martinhaugen99/project_in5590/docs/261022_deliverable-1_draft-v4.md

# M.A.T.S: An Animatronic Desk Cleaner on Tracks

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

*Mechanized Assistant for Tabletop Sanitation. Revised draft, 22 October 2026. This version replaces the desk-companion proposal after the feedback on the first draft.*

---

## 1. Topic and motivation

Desks collect crumbs, eraser dust and dust. Wiping them away by hand pushes the debris onto the floor or into the user's lap, and a hand vacuum is loud and must be fetched first. We will build **M.A.T.S** (Mechanized Assistant for Tabletop Sanitation), a small robot that cleans a desk on its own. It drives on tracks and pushes the debris ahead of a brush to the table edge. There it lowers a bucket on two arms over the edge, and the brush pushes the debris into the bucket. When the bucket is full, a person lifts it off, empties it and puts it back.

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

## 2. Goals

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

1. **Physical design (main focus, Must).** Design the body, the track drive, the brush arm and the bucket arms in parametric CAD, then print and assemble them. The design succeeds when all of these tests pass:
   - **Reach:** the bucket arms move the bucket from its stowed position above the head to a position past the table edge, with the bucket rim below the table top, without touching the edge. Pass: 10 of 10 tries.
   - **Upright bucket:** the bucket carries a full load of test debris from the dump position to the stowed position and back without spilling. Pass: no debris lost in 10 tries.
   - **No tipping:** in the worst pose (bucket lowered past the edge and full, brush pushed forward), both tracks stay flat on the table. Pass: checked in CAD with measured masses, then 10 of 10 tries on the table.
   - **Detachable bucket:** a person removes and reattaches the bucket with one hand and no tools.
   - **Brush contact:** when lowered, the brush touches the table along its full width. When raised, it clears the table.
2. **Safety (Must).**
   - When driving forward, the robot stops before any part of a track leaves the surface, at every speed. Pass: 10 of 10 approaches per speed, both head-on and at 45° to the edge, on three different tables, with no code changes between the tables.
   - The robot reverses only along the path it has just driven, and it turns in place only where its corners stay on the table. Pass: no track leaves the surface during the 10 dump cycles in goal 4.
   - The tracks cannot move while the bucket is lowered or the brush is pushed forward. Pass: drive commands sent in these states are ignored in 10 of 10 tries.
   - If the laptop cable comes loose, all motors stop. Pass: 10 of 10 tries, with the tracks off the ground.
   - A physical switch on the robot cuts the external power to all motors, servos and the linear actuator.
3. **Mobility (Must).** Drive 1 m forward and 1 m back along a taped line, and turn 360° in place, first with the brush raised and then with it lowered. Pass: 5 of 5 runs of each test without stalling and without a track slipping or coming off, ending within 5 cm of the start.
4. **Dump cycle (Must).** At the press of a button, the robot runs one full cycle on its own: lower the brush, drive to the edge, square up to it, stop, lower the bucket, push, stow and back away (Section 3). Pass: 10 cycles in a row on one table, with no fall and no step that gets stuck.
5. **Expression (Must).** Show seven states as animations, not still images (Table 1). Pass: in a test with at least 10 people outside the group, a majority recognize each state.
6. **Collection rate, the optimization task (Should).** Increase the share of debris that ends up in the bucket (Section 3). Pass: we report the rate before and after tuning, and the tuned rate is at least 80 % by mass.
7. **Autonomous cleaning (Should).** The robot cleans a table on its own: it repeats the dump cycle along different edges until it is stopped. Pass: 5 minutes of cleaning on each of three tables, with no fall.
8. **Reactions (Should).** The face changes with the events in Table 1. Pass: each event, triggered by hand, shows the right face within 1 s.
9. **Could.** A camera that finds dirty spots, and sounds.

### Inspiration

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

## 3. Sketch and scope

Side views of the cleaning cycle

*Figure 1: Side views of the cleaning cycle, steps 1–5.*

Top and side views with dimensions and internal layout

*Figure 2: Top and side views with the main dimensions and the placement of the internal parts.*

**How M.A.T.S cleans** (Figure 1):

1. **Sweep.** The brush arm lowers the brush onto the table, and the robot drives forward. The debris collects in a pile ahead of the brush.
2. **Approach the edge.** The two edge sensors on the brush bracket see the edge. If only one of them sees it, the robot turns until both do, so that it stands square to the edge. The tracks stop while the pile is still on the table.
3. **Lower the bucket.** The bucket arms swing from above the head, over the brush and down, until the bucket hangs past the edge with its rim below the table top.
4. **Push.** The linear actuator pushes the brush forward along its rail, and the pile drops over the edge into the bucket.
5. **Stow and move on.** The actuator pulls the brush back, and the bucket rises to its place above the head. The robot then backs away along the path it came and turns toward a new strip of the table.

The tracks are locked during steps 3 to 5.

**Main parts** (labeled in Figures 1 and 2):

- **Body and head.** A 3D-printed PLA body. The display, a 2.8-inch color screen, sits in a fixed head on top of the body.
- **Tracks.** Two tracks printed in TPU as closed bands with teeth on the inside. They run on printed PLA sprockets with guide ridges. On each side, a DC gearmotor drives the rear sprocket, and the front sprocket runs free in a slotted mount, so that we can adjust the track tension after printing.
- **Encoders.** Each motor has a second output shaft, which turns an encoder through a printed TPU coupling. Each encoder has its own bracket, because its shaft takes at most 10 N of side load[^e6a2] and must not carry the track tension.
- **Brush arm.** One central arm at the front of the body, raised and lowered by a micro servo. The brush is fixed to the arm at an angle that makes it flat on the table when lowered. The arm lifts the brush only slightly, so the brush tilts only a little when raised. The brush slides on a guide rail at the tip of the arm. A linear actuator with a 20 mm stroke and position feedback pushes it forward and pulls it back[^pq12]. The rail takes the side loads, so the actuator only pushes along its own axis.
- **Bucket arms.** Two arms, one on each side of the body, fixed to a shaft through the middle of the body and driven by one micro servo. The arm hubs and the body leave room for a larger servo, in case the micro servo is too weak. The bucket hangs between the arm tips on two ball bearings, and ballast in its bottom keeps it upright in every arm position. The bucket rests on its pivots in open hooks, so a person can lift it off to empty it.
- **Edge sensors.** Two downward time-of-flight sensors sit at the left and right ends of the brush bracket, one ahead of each track, and ahead of the bristles. They run the safety reflex and guide the approach to the edge. With one sensor ahead of each track, the robot also sees an edge that it meets at an angle. The brush lifts only a few millimeters, while the drop at an edge is the full height of the table, so one threshold works with the brush up or down. If the arm fails and the sensors tilt up, they read a long distance, and the reflex stops the robot.
- **No rear sensors.** The robot reverses only along the path it has just driven, and never farther than the encoders measured on the way forward. Before it turns in place near an edge, it backs away until its corners stay on the table during the turn.
- **Inside the body.** One soldered board holds the microcontroller, the two motor driver chips and the pull-up and pull-down resistors. The body also holds the two step-down converters and the IMU. The motors and encoders sit low at the rear, as a counterweight to the bucket. The power cables and the cut-off switch are at the rear.

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

One 12 V bench supply powers all actuators through one cable:
- The linear actuator runs directly on 12 V.
- One adjustable step-down converter feeds the track motors. The motor driver chips drop part of the voltage[^l293d], so we set the converter so that the motors get about their suggested 4.5 V at full speed[^dg01d].
- A second converter feeds the servos at 5 V.
- The encoders run on 12 V, connected before the cut-off switch, so they keep counting when the motors are cut. Their outputs are open collector, so pull-up resistors to 3.3 V keep the signals at the microcontroller's logic level[^e6a2].

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

*Table 1: The seven states and their triggers.*

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

```
edge sensors (2), encoders, ──► LOW LEVEL ───────────────────► driver chip 1 ──► track motors (rear sprockets)
actuator position, IMU          edge reflex, dump interlock, ──► servo signals ──► brush-arm and bucket-arm servos
                                motor, servo and actuator    ──► driver chip 2 ──► linear actuator (brush push)
                                control, watchdog
                                   ▲ commands     │ state / events
buttons ──────────────────► HIGH LEVEL: cleaning behavior, emotion state ──► display renderer
```

The low level checks the edge sensors in every loop iteration before it applies any motor command, and it uses the encoders to keep the robot on its own path when it reverses. It lowers the bucket only when the tracks are stopped and both edge sensors see the edge ahead, and it keeps the tracks locked until the bucket is up and the brush is back. The high level can only send commands to the low level, so the cleaning behavior can never override the edge stop or the interlock. If the USB cable comes loose, the microcontroller loses power, and pull-down resistors on the driver inputs stop the motors.

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

## 4. Bill of materials (BOM)

We use the lab's equipment wherever we can. Only three items must be bought, all from RS, as the assignment asks. The last two rows are an optional part and a fallback, which we buy only if needed.

| # | Component | Part | Function | Qty | Source |
|---|---|---|---|---|---|
| 1 | Microcontroller | [Arduino Nano ESP32](https://store.arduino.cc/products/nano-esp32) (ESP32-S3, 3.3 V logic) | Low-level control, behavior and display | 1 | Lab |
| 2 | Track motors | [DAGU DG01D 48:1 hobby gearmotor](https://www.sparkfun.com/hobby-gearmotor-140-rpm-pair.html), output shaft on both sides | Drive the rear sprockets | 2 | Lab |
| 3 | Encoders | Yumo E6A2-CW3C, 200 pulses per turn, open-collector outputs (same as the [Omron E6A2-CW3C](https://www.fa.omron.co.jp/data_pdf/cat/e6a2-c_ds_e_8_2_csm490.pdf)) | Measure the motion of each track | 2 | Lab |
| 4 | Motor drivers | [TI L293DNE](https://www.ti.com/product/L293D), two motor channels per chip | One chip for the track motors, one for the linear actuator | 2 | Lab |
| 5 | Arm servos | [DFRobot SER0006 micro servo](https://www.digikey.com/en/products/detail/dfrobot/SER0006/7597224) | Raise and lower the brush arm and the bucket arms | 2 | Lab |
| 6 | Spare arm servo | Larger hobby servo | Replaces a micro servo that turns out to be too weak | 1 | Lab |
| 7 | Linear actuator | [Actuonix PQ12-100-12-P](https://www.robotshop.com/products/actuonix-pq12-p-linear-actuator-20mm-1001-12v-potentiometer) (20 mm stroke, 12 V, position feedback) | Push the brush forward and pull it back | 1 | Lab |
| 8 | Display | 2.8" SPI TFT module, ILI9341 controller, 240 × 320 pixels (board V1.2) | The face | 1 | Lab |
| 9 | IMU | [SparkFun OpenLog Artemis](https://www.sparkfun.com/sparkfun-openlog-artemis.html) (built-in ICM-20948 IMU), data over its serial TX pin | Detect tilt and pick-up (Should) | 1 | Lab |
| 10 | Buttons | Push buttons | Start and stop; "bucket emptied" | 2 | Lab |
| 11 | Power supply | Bench power supply set to 12 V, with cable | Power for all actuators | 1 | Lab |
| 12 | Step-down converters | Adjustable step-down (buck) converter, model to be confirmed | Motor rail and 5 V servo rail | 2 | Lab |
| 13 | Cut-off switch | Switch in the 12 V cable, mounted on the robot | Cut the power to all actuators | 1 | Lab |
| 14 | Edge sensors | [ST SATEL-VL53L4CD](https://no.rs-online.com/web/p/sensor-development-tools/2410906) (RS 241-0906), VL53L4CD time-of-flight sensor, two boards per kit | Safety reflex and edge approach, one sensor ahead of each track | 2 kits (2 sensors used, 2 spare) | Buy: RS |
| 15 | Brush | [RS PRO nylon brush strip](https://no.rs-online.com/web/p/door-seals/3269814) (RS 326-9814), cut to width | The brush | 1 | Buy: RS |
| 16 | Bearings | [RS PRO 623-2Z ball bearing](https://no.rs-online.com/web/p/ball-bearings/2612628), 3 × 10 × 4 mm (RS 261-2628) | Bucket pivots | 2 | Buy: RS |
| 17 | Ballast | Lead or steel weights | Keep the bucket upright | – | Lab |
| 18 | Filament | PLA and TPU | Printed parts; TPU for the tracks and the encoder couplings | – | Lab |
| 19 | Small parts | Solderable board, IC sockets, pull-up and pull-down resistors, wires, connectors, M2/M3 screws | Assembly | – | Lab |
| 20 | Camera (Could) | Raspberry Pi 5 and Raspberry Pi camera | Find dirty spots | 1 | Lab |
| 21 | Pin expander (optional) | [Microchip MCP23017-E/SP](https://www.digikey.com/en/products/detail/microchip-technology/MCP23017-E-SP/894272), 16 pins over I2C, through-hole | More pins, if the microcontroller runs short | 1 | Buy if needed: DigiKey or RS (RS 040-3806) |
| 22 | Tracks (fallback) | [Pololu 30T track set](https://www.pololu.com/product/3033) (#3033) | Replace the printed tracks if they fail | 1 set | Buy if needed: [DigiKey](https://www.digikey.no/no/supplier-centers/pololu) |

When the model of the lab's step-down converters is known, we check it and the motor drivers against the stall currents of the motors and servos. The bearing size will be confirmed in CAD.

## 5. Plan

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

| Iteration | Week (dates) | Main tasks (responsible) | Milestone: done when |
|---|---|---|---|
| I0 | W41–W42 (5–18 Oct) | First proposal, Deliverable 4A (11 Oct) and the 4B project review (both) | **M0:** Done. The concept was changed after the feedback |
| I1 | W43 (19–25 Oct) | Revised concept, sketches and deliverable (both); collect the lab parts and send the order list for the edge sensors, brush and bearings to the faculty (Yuki); CAD v0: layout of the main parts and the arm geometry, using measured part sizes (Martin) | **M1:** The revised deliverable is handed in, the lab parts are in hand, and the order list is sent |
| I2 | W44 (26 Oct–1 Nov) | CAD v1 of the body, track drive, brush arm and bucket arms (Martin); test prints: a TPU track section with sprockets, the encoder couplings, the arm hubs on the servos, the brush rail with the linear actuator, and the bucket mount with bearings and ballast (Martin); bring up the motors with encoders and driver chips, the servos, the linear actuator, the display and the IMU data stream on the bench (Yuki); design the faces on the laptop (Martin) | **M2:** CAD v1 is done, and each test print and part works on the bench |
| I3 | W45 (2–8 Nov) | Print and assemble robot v1 (Martin); track control with the encoders, speed cap, watchdog, motor stop on a lost USB cable, edge reflex and the reversing rule (Yuki); Project part 1, due 8 Nov (both) | **M3:** The robot passes the mobility test and stops at the edge on a table, and Project part 1 is handed in |
| I4 | W46 (9–15 Nov) | Arm control, the linear actuator, squaring up to the edge, and the dump cycle with its interlock (Yuki); reach, tipping and servo-torque tests, and CAD v2 from the results (Martin); faces on the display (Martin); Project part 2, due 15 Nov (both) | **M4 (MVP):** On a real table, the robot runs a full dump cycle at the press of a button and never falls off, and Project part 2 is handed in |
| I5 | W47 (16–22 Nov) | Print and assemble v2 (Martin); autonomous cleaning (Yuki); collection-rate experiments and tuning (Yuki); animate the seven states and connect them to events (Martin) | **M5:** Feature freeze: the robot cleans a table on its own, and the experiment data is logged |
| I6 | W48 (23–29 Nov) | Emotion recognition test (Martin); tests on three tables (Yuki); fixes, demo rehearsal and spare parts (both) | **M6:** The robot is ready for the demo |
| Demo | Monday 30 Nov | Public demo, Project part 3 (both) | **M7:** Demo done |

**Main areas of responsibility**

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

**Risks and what we do about them**

| Risk | What we do |
|---|---|
| The bought edge sensors arrive late | Send the order in I1, and test the drive and the arms with lab parts until the sensors arrive. |
| The printed TPU tracks slip, stretch or come off | Print and test a track section in I2, adjust the tension with the slotted front mounts, and use guide ridges on the sprockets. The fallback is the Pololu track set. |
| The robot meets an edge at an angle | One edge sensor sits ahead of each track, and we test approaches at 45° in the safety tests. |
| The robot tips forward with the bucket out past the edge | Check the center of gravity in CAD with measured masses, and place the motors and encoders low at the rear. If the IMU is fitted, it also stops the robot when it tilts. |
| A micro servo is too weak for the bucket arms | Check the torque in CAD with measured masses, and swap in the larger lab servo, which the arm hubs and the body already fit. A counterweight behind the arm pivot also reduces the load. |
| A driver chip gets too hot when a track motor stalls | The firmware detects a stall from the encoders and cuts the motor. The fallback for the track motors is an L298N driver module that we already have. |
| The printed sprockets or encoder couplings slip on the plastic motor shafts | Measure the shafts, and print several bore sizes in one test print in I2. |
| The pile falls off the edge before the bucket is in place | The edge sensors sit on a bracket ahead of the bristles, and we tune the stop gap. |
| The 20 mm stroke is too short to push the pile into the bucket | Place the edge sensors so that the stop gap fits within the stroke, and use the encoders to stop accurately. A lever on the rail can lengthen the push. |
| The bucket swings when the debris lands in it | Tune the ballast mass and the friction in the pivots, and add a soft end stop. |
| The microcontroller has too few pins | Use one shutdown pin for both edge sensors, tie the display's chip-select low, and read both buttons on one analog pin. The MCP23017 pin expander is the fallback. |
| We fall behind the schedule | Drop the Could goals first, then autonomous cleaning, and keep the dump cycle at the press of a button. The MVP (M4) has priority, and I6 has time for fixes. |

---

[^roomba]: "Roomba," *Wikipedia*. <https://en.wikipedia.org/wiki/Roomba> (accessed 21 October 2026).
[^cozmo-sdk]: Anki, *Cozmo Python SDK*, `robot.py`, methods `is_cliff_detected` and `enable_stop_on_cliff`. <https://github.com/anki/cozmo-python-sdk/blob/master/src/cozmo/robot.py>
[^cozmo]: "Cozmo," *Wikipedia*. <https://en.wikipedia.org/wiki/Cozmo> (accessed 21 October 2026).
[^walle]: "WALL-E (character)," *Wikipedia*. <https://en.wikipedia.org/wiki/WALL-E_(character)> (accessed 21 October 2026).
[^zumo]: Pololu, "Zumo 32U4 Robot," item #3125. <https://www.pololu.com/product/3125> (accessed 9 October 2026).
[^takayama]: L. Takayama, D. Dooley and W. Ju, "Expressing thought: improving robot readability with animation principles," in *Proc. 6th ACM/IEEE International Conference on Human-Robot Interaction (HRI)*, 2011, pp. 69–76. [doi:10.1145/1957656.1957674](https://doi.org/10.1145/1957656.1957674)
[^vanbreemen]: A. J. N. van Breemen, "Bringing robots to life: Applying principles of animation to robots," in *Proc. Shaping Human-Robot Interaction Workshop, CHI 2004*, Vienna, Austria, 2004.
[^e6a2]: OMRON, "Incremental 25-mm-dia. Rotary Encoder E6A2-C," datasheet CSM_E6A2-C_DS_E_8_2. <https://www.fa.omron.co.jp/data_pdf/cat/e6a2-c_ds_e_8_2_csm490.pdf>
[^pq12]: Actuonix, "PQ12 Micro Linear Actuators," datasheet. <https://cdn.robotshop.com/media/f/fir/rb-fir-42/pdf/actuonix-pq12-datasheet.pdf> (accessed 22 October 2026).
[^dg01d]: SparkFun, "Hobby Gearmotor - 140 RPM (Pair)," ROB-13302. <https://www.sparkfun.com/hobby-gearmotor-140-rpm-pair.html> (accessed 22 October 2026).
[^l293d]: Texas Instruments, "L293x Quadruple Half-H Drivers," datasheet SLRS008D. <https://www.ti.com/lit/gpn/l293d> (accessed 22 October 2026).
[^ekman]: P. Ekman, "An argument for basic emotions," *Cognition and Emotion*, vol. 6, no. 3–4, pp. 169–200, 1992. [doi:10.1080/02699939208411068](https://doi.org/10.1080/02699939208411068)
