martinhaugen99/project_in5590/docs/figures/1exploded.png

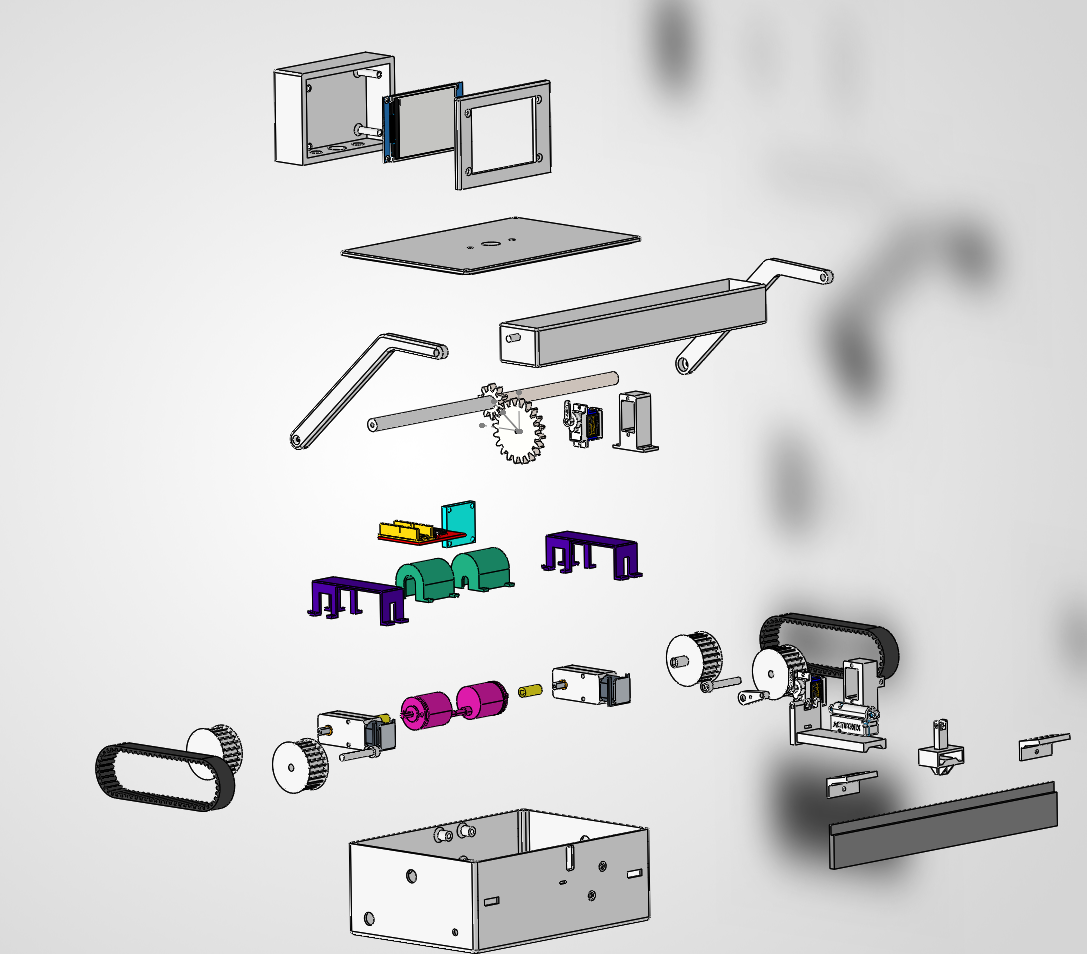
docs/figures/1exploded.png
