martinhaugen99/project_in5590/bom.csv

item | component | part | function | mpn | supplier | link | datasheet | qty | unit_price | currency | unit_price_nok | status | price_checked | notes
1 | microcontroller | Arduino Nano ESP32 | Low-level control, behavior and display |  | Lab | https://store.arduino.cc/products/nano-esp32 |  | 1 |  |  |  | lab |  | ESP32-S3, 3.3 V logic. D004
2 | drive_motor | DAGU DG01D 48:1 hobby gearmotor | Drive the rear sprockets | DG01D | Lab | https://www.sparkfun.com/hobby-gearmotor-140-rpm-pair.html |  | 2 |  |  |  | lab |  | Output shaft on both sides. About 140 RPM without load, suggested 4.5 V (SparkFun ROB-13302). D006
3 | encoder | Yumo E6A2-CW3C rotary encoder | Measure the motion of each track | E6A2-CW3C | Lab |  | https://www.fa.omron.co.jp/data_pdf/cat/e6a2-c_ds_e_8_2_csm490.pdf | 2 |  |  |  | lab |  | 200 pulses per turn, open-collector outputs. Same as the Omron E6A2-CW3C. Shaft side load at most 10 N, so each encoder has its own bracket. D006
4 | motor_driver | TI L293DNE | One chip for the track motors, one for the linear actuator | L293DNE | Lab | https://www.ti.com/product/L293D | https://www.ti.com/lit/gpn/l293d | 2 |  |  |  | lab |  | Two motor channels per chip. Fallback for the track motors: L298N driver module (lab). D006
5 | servo | DFRobot SER0006 micro servo | Raise and lower the brush arm and the bucket arms | SER0006 | Lab | https://www.digikey.com/en/products/detail/dfrobot/SER0006/7597224 | https://www.dfrobot.com/product-255.html | 2 |  |  |  | lab |  | Turns 180°. D008
6 | servo | Larger hobby servo | Replaces a micro servo that turns out to be too weak |  | Lab |  |  | 1 |  |  |  | lab |  | Spare. The arm hubs and the body leave room for it. D008
7 | linear_actuator | Actuonix PQ12-100-12-P | Push the brush forward and pull it back | PQ12-100-12-P | Lab | https://www.robotshop.com/products/actuonix-pq12-p-linear-actuator-20mm-1001-12v-potentiometer | https://cdn.robotshop.com/media/f/fir/rb-fir-42/pdf/actuonix-pq12-datasheet.pdf | 1 |  |  |  | lab |  | 20 mm stroke, 12 V, position feedback. D008
8 | display | 2.8 in SPI TFT module, ILI9341 controller, 240 x 320 pixels (board V1.2) | The face |  | Lab |  |  | 1 |  |  |  | lab |  | Datasheet of the module not yet linked. D009
9 | imu | SparkFun OpenLog Artemis | Detect tilt and pick-up (Should) |  | Lab | https://www.sparkfun.com/sparkfun-openlog-artemis.html |  | 1 |  |  |  | lab |  | Built-in ICM-20948 IMU, data over its serial TX pin. D010
10 | button | Push button | Start and stop; bucket emptied |  | Lab |  |  | 2 |  |  |  | lab
11 | power_supply | Bench power supply set to 12 V, with cable | Power for all actuators |  | Lab |  |  | 1 |  |  |  | lab |  | D005
12 | step_down_converter | Adjustable step-down (buck) converter | Motor rail and 5 V servo rail |  | Lab |  |  | 2 |  |  |  | lab |  | Model to be confirmed. Then check it and the motor drivers against the stall currents of the motors and servos. D005
13 | motor_cutoff_switch | Switch in the 12 V cable, mounted on the robot | Cut the power to all actuators |  | Lab |  |  | 1 |  |  |  | lab |  | D005
14 | edge_sensor | ST SATEL-VL53L4CD, VL53L4CD time-of-flight sensor, two boards per kit | Safety reflex and edge approach, one sensor ahead of each track | SATEL-VL53L4CD | RS | https://no.rs-online.com/web/p/sensor-development-tools/2410906 |  | 1 |  |  |  | to_order |  | One kit, two sensors. RS 241-0906. D007
15 | brush | RS PRO nylon brush strip, cut to width | The brush |  | RS | https://no.rs-online.com/web/p/door-seals/3269814 |  | 1 |  |  |  | to_order |  | RS 326-9814. D008
16 | bearing | Ball bearings | Bucket pivots |  | Lab |  |  | 2 |  |  |  | lab |  | Size to be measured. D008
17 | ballast | Lead or steel weights | Keep the bucket upright |  | Lab |  |  |  |  |  |  | lab |  | D008
18 | filament | PLA and TPU | Printed parts; TPU for the tracks and the encoder couplings |  | Lab |  |  |  |  |  |  | lab
19 | small_parts | Solderable board, IC sockets, pull-up and pull-down resistors, wires, connectors, M2/M3 screws | Assembly |  | Lab |  |  |  |  |  |  | lab
20 | camera | Raspberry Pi 5 and Raspberry Pi camera | Find dirty spots (Could) |  | Lab |  |  | 1 |  |  |  | optional |  | D004
