martinhaugen99/project_in5590/(list of files, cad)

Other CAD files:
cad/bucket_arms/bucket_arms.SLDASM
cad/mats.SLDASM
cad/track_drive/track_drive.SLDASM
cad/body/body.SLDASM
cad/head/head.SLDASM
cad/brush_arm/brush_arm.SLDASM
cad/body/body_chassis.SLDPRT
cad/brush_arm/guide_rail.SLDPRT
cad/head/head_box_back.SLDPRT
cad/brush_arm/coupling_brush_linear_actuator.SLDPRT
cad/bucket_arms/bucket_arms_gear_rod_reduced.SLDPRT
cad/track_drive/track.SLDPRT
cad/body/solderable_breadboard.SLDPRT
cad/bucket_arms/bucket_arms_gear_rod.SLDPRT
cad/head/head_lid_face.SLDPRT
cad/track_drive/track_sprocket_idler.SLDPRT
cad/body/imu.SLDPRT
cad/brush_arm/servo_mount_brush.SLDPRT
cad/bucket_arms/bucket_arm.SLDPRT
cad/track_drive/track_sprocket_drive.SLDPRT
cad/body/motor_mount.SLDPRT
cad/brush_arm/edge_sensor_mount.SLDPRT
cad/bucket_arms/Mirrorbucket_arm.SLDPRT
cad/track_drive/track_round.SLDPRT
cad/body/encoder_mount.SLDPRT
cad/brush_arm/coupling_servo_linear_actuator.SLDPRT
cad/bucket_arms/bucket_arms_servo_gear.SLDPRT
cad/body/body_lid.SLDPRT
cad/brush_arm/Mirroredge_sensor_mount.SLDPRT
cad/bucket_arms/servo_mount.SLDPRT
cad/body/coupling_drive_motor_encoder.SLDPRT
cad/brush_arm/brush.SLDPRT
cad/bucket_arms/rod.SLDPRT
cad/bucket_arms/bucket.SLDPRT
cad/purchased/display_2_8_in_spi.SLDPRT
cad/purchased/drive_motor_dg01d.SLDPRT
cad/purchased/edge_sensor_satel_vl53l4cd.SLDPRT
cad/purchased/encoder_e6a2_cw3c.SLDPRT
cad/purchased/imu_openlog_artemis.SLDPRT
cad/purchased/linear_actuator_pq12_100_12_p.SLDPRT
cad/purchased/microcontroller_nano_esp32.SLDPRT
cad/purchased/motor_driver_l293dne.SLDPRT
cad/purchased/servo_ser0006.SLDPRT
cad/track_drive/track_idler_screw.SLDPRT
