martinhaugen99/project_in5590/print_params.md

# Print parameters:

Layer height 0.2mm for all

**Make bigger holes**

## Body:

- body chassis: 40% infill
- body lid: 15% infill
- coupling drive motor encoder(x2): 100% infill - **redesign**
- encoder mount(x2): 60% infill
- motor mount(x2): 60% infill

## Head:

- head box back: 40% infill
- head lid face: 40% infill - fits

## Track Drive:

- track idler screw(x2): 100% infill
- track sprocket drive(x2): 60% infill
- track sprocket idler(x2): 60% infill
- track(x2, tpu):

## Bucket Arms:

- bucket: 40% infill
- bucket arm right: 40% infill
- bucket arm left(mirrored): 40% infill
- servo mount: 60% infill
- bucket arms servo gear: 100% infill
- rod: 100% infill
- bucket arms gear rod reduced: 100% infill

## Brush Arm:

- coupling brush linear actuator: 40% infill
- coupling servo linear actuator: 100% infill
- edge sensor mount: 40% infill
- guide rail slot: 40% infill
- mirrord edge sensor mount: 40% infill
- servo mount brush: 40% infill
