martinhaugen99/project_in5590/docs/figures/1assembled.png

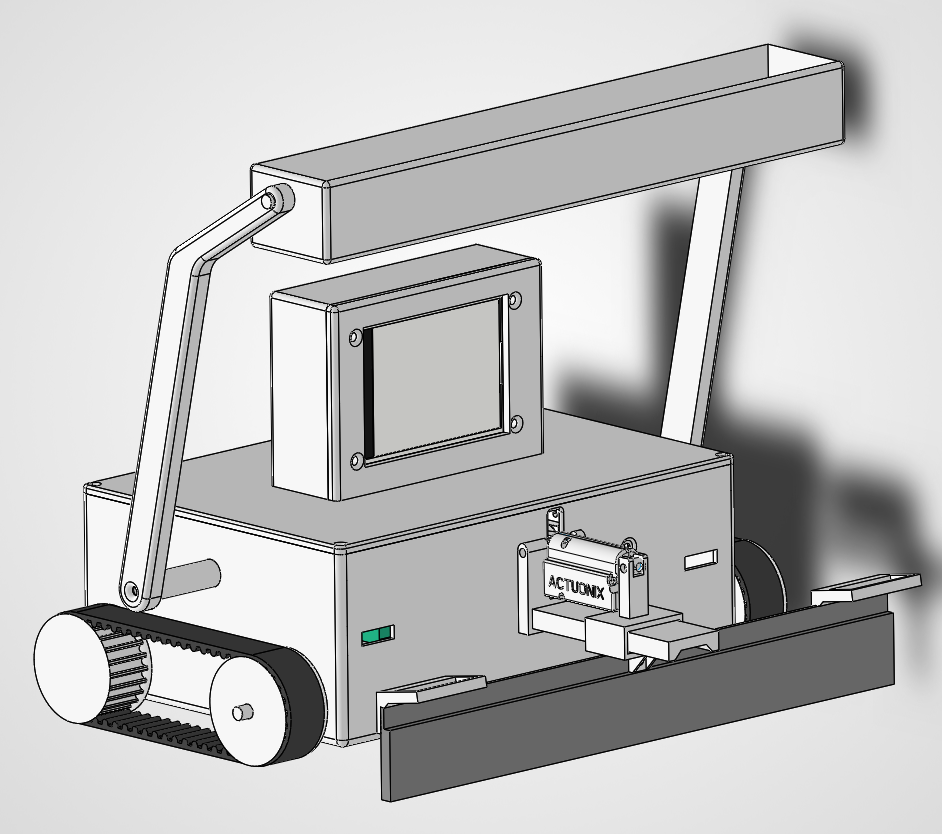
docs/figures/1assembled.png
