martinhaugen99/project_in5590/docs/how_to_uv_claude.png

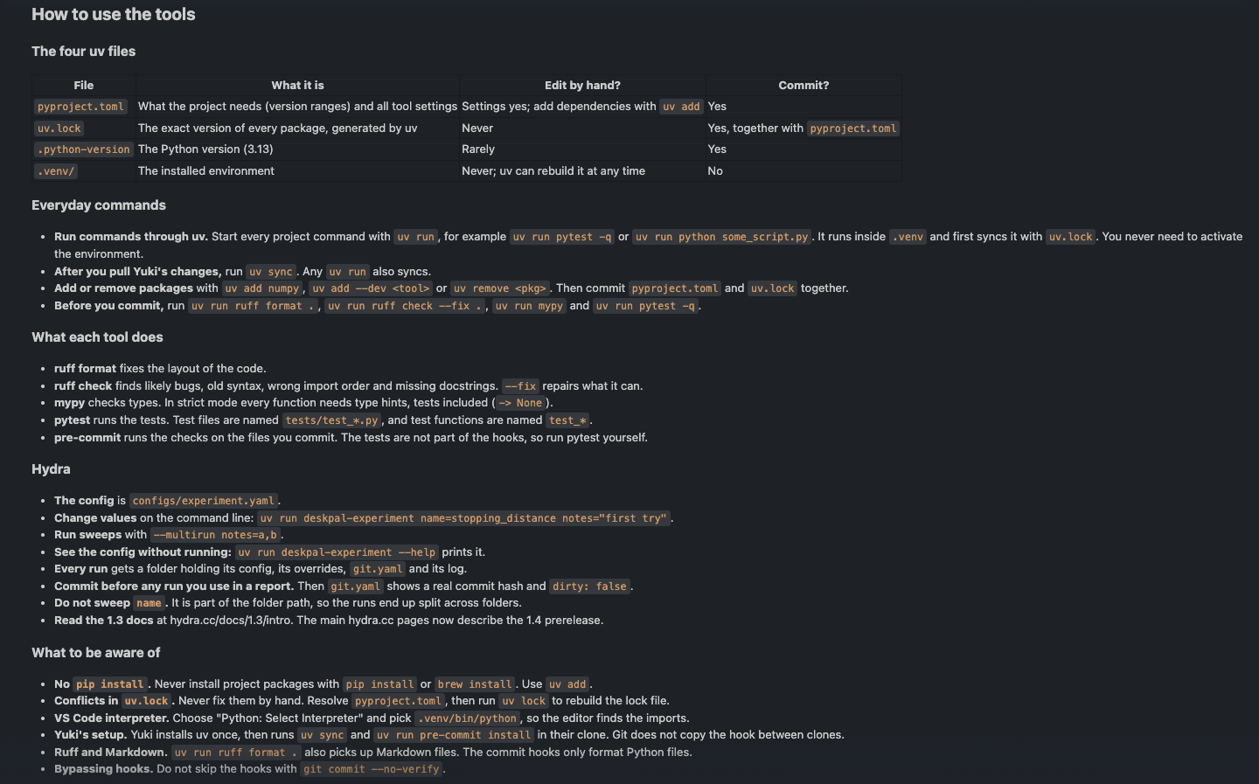
docs/how_to_uv_claude.png
