martinhaugen99/project_in5590/(commit log)

2026-10-10 add deliverable 1 draft, sketch and bom
    [bom.csv]
2026-10-24 rewrite bom for the M.A.T.S design
    [bom.csv]
2026-10-24 track solidworks files in git lfs with locks
2026-10-24 add cad structure and lock workflow
2026-10-24 add cad parameter table and module owners
2026-10-24 record decision D012 for shared cad dimensions
2026-11-03 add vendor models for motor, encoder, MCU
    [drive_motor_dg01d.SLDPRT, encoder_e6a2_cw3c.SLDPRT, microcontroller_nano_esp32.SLDPRT]
2026-11-06 add vendor models for sensors, servo, actuator
    [display_2_8_in_spi.SLDPRT, edge_sensor_satel_vl53l4cd.SLDPRT, imu_openlog_artemis.SLDPRT, linear_actuator_pq12_100_12_p.SLDPRT, motor_driver_l293dne.SLDPRT, servo_ser0006.SLDPRT]
2026-11-06 body_chassis: box with holes for screws; body: assembly with body chassis and drive motors
    [body.SLDASM, body_chassis.SLDPRT]
2026-11-07 fixed motor and encoder mount, updated body assembly
    [body.SLDASM, body_chassis.SLDPRT, drive_motor_dg01d.SLDPRT, encoder_mount.SLDPRT, motor_mount.SLDPRT]
2026-11-08 drive motor and encoder coupled, track drive, lid and full assembly created
    [body.SLDASM, body_chassis.SLDPRT, body_lid.SLDPRT, coupling_drive_motor_encoder.SLDPRT, mats.SLDASM, motor_mount.SLDPRT, solderable_breadboard.SLDPRT, track.SLDPRT]
2026-11-09 finished head and attached to full assembly, fixed gears for bucket arms
    [body.SLDASM, body_chassis.SLDPRT, body_lid.SLDPRT, bucket_arms.SLDASM, bucket_arms_gear_rod.SLDPRT, bucket_arms_servo_gear.SLDPRT, display_2_8_in_spi.SLDPRT, head.SLDASM]
2026-11-10 finished bucket arm and added to full assembly, rotation does not work in full assembly
    [Mirrorbucket_arm.SLDPRT, body.SLDASM, body_chassis.SLDPRT, bucket.SLDPRT, bucket_arm.SLDPRT, bucket_arms.SLDASM, mats.SLDASM]
2026-11-10 started on brush arm, need to redesign guide rail
    [brush_arm.SLDASM, coupling_servo_linear_actuator.SLDPRT, guide_rail_slot.SLDPRT, mats.SLDASM, servo_ser0006.SLDPRT]
2026-11-11 ignore .stl files
2026-11-11 finished brush arm, added to full assembly, need to fix converters, pcb mount, buttons and holes
    [Mirrorbucket_arm.SLDPRT, Mirroredge_sensor_mount.SLDPRT, body.SLDASM, body_chassis.SLDPRT, brush.SLDPRT, brush_arm.SLDASM, bucket_arm.SLDPRT, bucket_arms.SLDASM]
2026-11-12 params first print
2026-11-12 changed design based on first print
    [Mirroredge_sensor_mount.SLDPRT, body.SLDASM, body_chassis.SLDPRT, brush_arm.SLDASM, bucket_arms.SLDASM, coupling_brush_linear_actuator.SLDPRT, coupling_brush_linear_actuator_v2.SLDPRT, coupling_servo_linear_actuator.SLDPRT]
2026-11-13 missing: cable holes and mount for imu in body
    [Mirrorbucket_arm.SLDPRT, Mirroredge_sensor_mount.SLDPRT, body.SLDASM, body_chassis.SLDPRT, brush_arm.SLDASM, bucket_arm.SLDPRT, bucket_arms.SLDASM, bucket_arms_gear_rod.SLDPRT]
2026-11-14 print params for all parts
2026-11-14 finished body and all is in print, changes noted in readme
    [body.SLDASM, body_chassis.SLDPRT, bucket_arms.SLDASM, mats.SLDASM]
2026-11-14 rename brush coupling and guide rail
    [brush_arm.SLDASM, coupling_brush_linear_actuator.SLDPRT, coupling_brush_linear_actuator_v2.SLDPRT, guide_rail.SLDPRT, guide_rail_slot.SLDPRT]
